Mohamadkhosravi/SINA_Cooling_Control/Hardware/Docs/Read me.docx

تغییرات ورژن I_1.3.5 بر اساس ورژن I_1.3

1- اضافه شدن fiducial point به لایه top past

تغییرات ورژن I_1.3 بر اساس ورژن I_1.2

1- تغییر سوکت پروگرامر
2- تغییر مقدار مقاومت بک لایت از 22 اهم به 10 اهم (R1)

تغییرات ورژن I_1.2 بر اساس ورژن I_1.1

1- دور کردن قطعات از ای سی درایور و انکودر
2- تغییر سوکت پروگرمر

تغییرات ورژن I_1.1 بر اساس ورژن I_1.0

1- Top and bottom paste fix

تغییرات ورژن I_1.0 بر اساس ورژن I_0.9

1- اضافه کردن دیود حفاظت برای نمونه گیری ازvcc4 برای بک لایت

تغییرات ورژن I_0.9 بر اساس ورژن I_0.8

1- اضافه شدن تست پوینت
2- تغییر تمامی فوت پرینت ها (کوچک کردن فوت پرینت ها)

تغییرات ورژن I_0.8 بر اساس ورژن I_0.7

1- اضافه کردن پلیگان زیر پد های خازن الکترولیتی و سویچ
2- بزرگ کردن پد های میکرو کنترلر ( سه برابر محل نشیمنگاه ای سی)
3- کوچک کردن ترمال پد ای سی تغذیه
4- تغییر مدار کنترل ال ای دی بک لایت ال سی دی
5- اضافه کردن مدار حفاظت برای ac

تغییرات ورژن I_0.7 بر اساس ورژن I_0.6

1- جایگزینی آی سی تغذیه ncv4269 با ncv4276

تغییرات ورژن I_0.6 بر اساس ورژن I_0.4

1- تغییر سوراخ 5.4 میلیمتری برد برای جلوگیری کردن از فرورفتن برد هنگام پیچ بستن.
2- تغییر مکان R52 به علت درخواست مهندسی و گیر کردن به بدنه

تغییرات نسخه 1.13.000 بر اساس ورژن 1.09.000 :

1- اصلاح تغییر IC ATMEL و ONSEMI
2- اضافه کرد زمان ریست پانل برای ولتاژ کم یا اضافه تر از حد مجاز

تغییرات نسخه 1.09.000 بر اساس ورژن 1.08.000 :

3- اصلاح ویز ویز کردن اکچویتورها و حذف Back emf
4- اصلاح عملکرد کلید مود در حالت پانل خاموش که دوباره از حالت قبل ادامه نمی داد
