Mohamadkhosravi/SINA_Cooling_Control/Hardware/OutputJobs/Saina-V1.32-1403_05_08.xlsx

BOM Version : Saina V1.32 1403/05/08
PCB Version : Saina V1.3 1403/04/23
Number | Specification |  | smd code | Package | Quantity
SMD components
1 | Thick Film Resistors 2.2Kohms 5% 1/8watt -55°C ~ 155°C | 11000048 | 222 | 0805 | 6 | R5, R6, R23, R24, R36, R37
2 | Thick Film Resistors 1/8watt 5.1Kohms 5% -55°C ~ 155°C | 11000165 | 512 | 0805 | 5 | R10, R27, R28, R34, R35
3 | Thick Film Resistors 1/8watt 10Kohms 5% -55°C ~ 155°C | 11000049 | 103 | 0805 | 12 | R13, R14, R15, R16, R25, R26, R38, R39, R51, R52,R8,R9
4 | Thick Film Resistors 1/8watt 47Kohms 5% -55°C ~ 155°C | 11000166 | 473 | 0805 | 2 | R21, R22
5 | Thick Film Resistors 1/8watt 510Kohms 5% -55°C ~ 155°C | 11000167 | 5103 | 0805 | 2 | R3, R4
6 | Thick Film Resistors 1/4watt 27ohms 1% -55°C ~ 155°C | 11000198 | 27R0 | 1206 | 1 | R50
7 | Thick Film Resistors 1/4watt 1.2Kohms 5% -55°C ~ 155°C | 11000169 | 122 | 1206 | 8 | R40, R41, R42, R43, R44, R45, R46, R53
8 | Thick Film Resistors 1/4watt 2Kohms 5% -55°C ~ 155°C | 11000171 | 202 | 1206 | 1 | R29
9 | Thick Film Resistors 1/4watt 3.6Kohms 1% -55°C ~ 155°C | 11000173 | 3601 | 1206 | 2 | R19, R20
10 | Thick Film Resistors 1/4watt 1.5Kohms 5% -55°C ~ 155°C | 11000170 | 152 | 1206 | 4 | R30, R31, R32, R33
11 | Thick Film Resistors 1/4watt 10Kohms 1% -55°C ~ 155°C | 11000540 | 1002 | 1206 | 2 | R17, R18
12 | Thick Film Resistors 1/8watt 10ohms 5% -55°C ~ 155°C | 11000800 | 100 | 0805 | 1 | R1
13 | Thick Film Resistors 1/8watt 100Kohms 5% -55°C ~ 155°C | 11000829 | 104 | 0805 | 1 | R2
14 | Thick Film Resistors 1/8watt 200Kohms 5% -55°C ~ 155°C | 11000830 | 204 | 0805 | 1 | R7
15 | Thick Film Resistors 1/8watt 470Kohms 5% -55°C ~ 155°C | 11000831 | 474 | 0805 | 1 | R55
16 | Thick Film Resistors 1/8watt 150Kohms 5% -55°C ~ 155°C | 11000832 | 154 | 0805 | 1 | R56
17 | Multilayer Ceramic Capacitors MLCC - SMD/SMT 50V 100nF X7R 10% -55°C ~ 125°C | 11000176 |  | 603 | 2 | C10, C61
18 | Multilayer Ceramic Capacitors MLCC - SMD/SMT 50V 1nF X7R 10% -55°C ~ 125°C | 11000174 |  | 0805 | 1 | C40
19 | Multilayer Ceramic Capacitors MLCC - SMD/SMT 50V 0.01uF X7R 10% -55°C ~ 125°C | 11000175 |  | 0805 | 14 | C17, C18, C19, C20, C21, C22, C24, C25, C26, C27, C28, C36, C39, C41
20 | Multilayer Ceramic Capacitors MLCC - SMD/SMT 50V 0.1uF X7R 10% -55°C ~ 125°C | 11000120 |  | 0805 | 15 | C3, C4, C7, C8, C11, C12, C13, C14, C16, C29, C30, C31, C32, C33, C34
21 | CAP CER 0.01uF 50V X7R 1210 | 11000177 |  | 1210 | 3 | C1, C37, C38
22 | CAP Tantalum 10.0UF 10.0V ESR<5Ohm 2000 Hrs @ 85°C -55°C ~ 125°C AEC-Q200 | 11000196 |  | 1206 (3216 Metric) | 1 | C5
23 | Aluminum Electrolytic Capacitors - SMD 25V 10uF 20% 2000 Hrs @ 85°C -55°C ~ 105°C Φ4*5/4mm | 11000179 |  | SMD-2 | 2 | C9, C15
24 | Aluminum Electrolytic Capacitors - SMD 50V 10uF 20% 2000 Hrs @ 85°C -55°C ~ 105°C Φ5*5/4mm | 11000195 |  | SMD-2 | 1 | C35
25 | Aluminum Electrolytic Capacitors - SMD 50V 100uF 2000 Hrs @ 85°C 20% -55°C ~ 105°C Φ8*10/5mm | 11000178 |  | SMD-2 | 2 | C2, C6
26 | 47UH 6*6*4mm | 11000180 |  | 6040 | 1 | LX1
27 | 1N4148WQ-7-F | 11000181 | W1 | SOD-123 | 9 | D5, D6, D13, D14, D15,D9, D10, D11, D12
28 | RS1M DIODE GEN PURP 1KV 1A -55°C ~ 150°C | 11000183 | RS1M | DO-214AC | 5 | D2, D3, D4, D7, D8
29 | S3M DIODE GEN PURP 1KV 3A -55°C ~ 150°C | 11000184 | S3M | DO-214AB | 1 | D1
30 | BC817-40 Bipolar Transistors - BJT 500mA 50V NPN -55°C ~ 150°C | 11000185 | 6CW | SOT-23 | 3 | Q1, Q3, Q4
31 | BCP56-16T1G TRANS NPN 80V 1A -65°C ~ 150°C | 11000186 |  | SOT-223 | 2 | Q5, Q6
32 | NCV8402ASTT1G IC DVR LO SIDE 42V 2.0A -40°C ~ 150°C | 11000187 |  | SOT-223 | 1 | Q2
33 | NCV4276DS50R4G IC REG LINEAR 5V 400MA -40°C ~ 125°C | 11000549 |  | D2PAK 5−LEAD | 1 | U1
34 | LM2904DT IC OPAMP GP 700KHZ -40°C ~ 125°C | 11000189 |  | SOP-8 | 1 | U5
35 | CAT93C46VI-JT3 | 11000164 |  | SOIC -8 | 1 | U8
36 | HT16K23 RAM Mapping 20*4/16*8 LCD Controller Driver -40°C ~ 85°C (reel packing) | 11000190 |  | SOP-28 | 1 | U3
37 | ATA6836C-TIQW IC HALF-BRIDGE DRVR SPI -40°C ~ 150°C (reel packing) | 11000210 |  | SOP-28 | 1 | U4
Alternative | NCV7708BDWR2G 28-SOIC | 11000193 |  | SOP-28 | 1 | U4
38 | XMC1302T038X0032ABXUMA1 PG-TSSOP-38-9 | 11000215 |  | PG-TSSOP-38-9 | 1 | U2
39 | TZ-SMD0805Y2HD LED805 YELLOW 0805 | 11000334 |  |  | 1 | L9
40 | SKPMAPE010 SWITCH 6*6*5MM , Alps | 11000192 |  |  | 1 | S4
Alternative | LED L-C170KYCT-SK | 11000718 |  |  | 1 | L9
41 | TZ-SMD1206W3HL LED WHITE 1206 | 11000338 |  |  | 6 | L12-L14-L16-L15-L13-L17
Alternative | LED L-C150WZDT-HT | 11000719 |  |  | 6 | L12-L14-L16-L15-L13-L17
42 | TZ-SMD1206B2HD LED BLUE 1206 | 11000336 |  |  | 1 | L11
Alternative | LED L-C150LBCT | 11000720 |  |  | 1 | L11
43 | TZ-SMD1206R2HD LED RED 1206 | 11000337 |  |  | 1 | L10
Alternative | LED L-C150KRCT | 11000721 |  |  | 1 | L10
44 | LED L-T670WDT | 11000335 |  |  | 8 | L1-L2-L3-L4-L5-L6-L7-L8
Alternative | H3528AW34E03012 LED white | 11000615 |  |  | 8 | L1-L2-L3-L4-L5-L6-L7-L8
Through-hole components
45 | EC28A1560401 Rotary Encoder, Straight, Without Push Switch | 11000197 |  |  | 1 | SE1
46 | connector 8p | 12100135 |  |  | 1 | J2
47 | connector 18Pin | 12100483 |  |  | 1 | J3
48 | LCD Saina | 11000471 |  |  | 1 | LCD1
