Mohamadkhosravi/SINA_Cooling_Control/Hardware/3DModels/SOLID/Connector1.sldprt

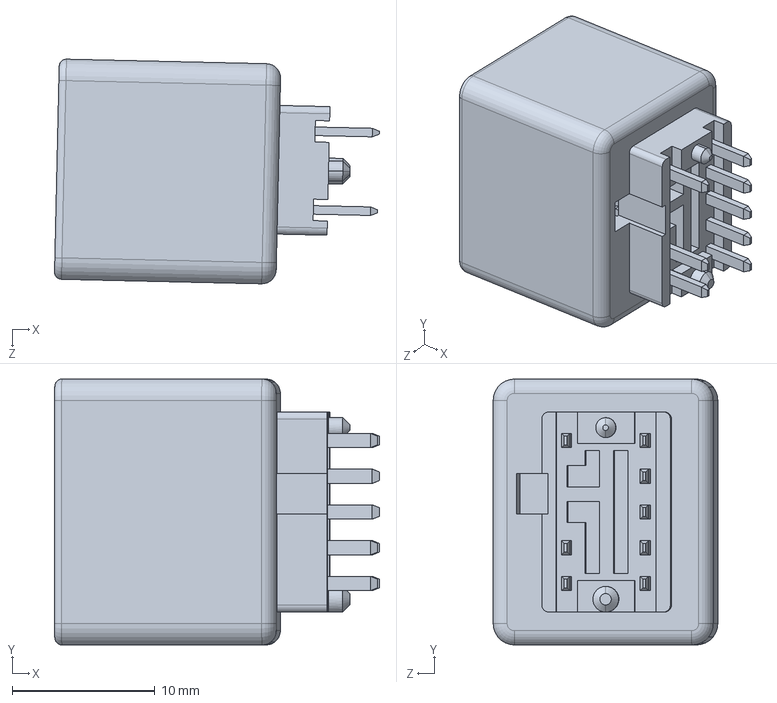
[picture p1: CAD file, 2025-05-04]
Hardware/3DModels/SOLID/Connector1.sldprt
22.7 x 18.6 x 15.7 mm
