Mohamadkhosravi/SINA_Cooling_Control/Hardware/3DModels/SOLID/lcd holder.sldprt

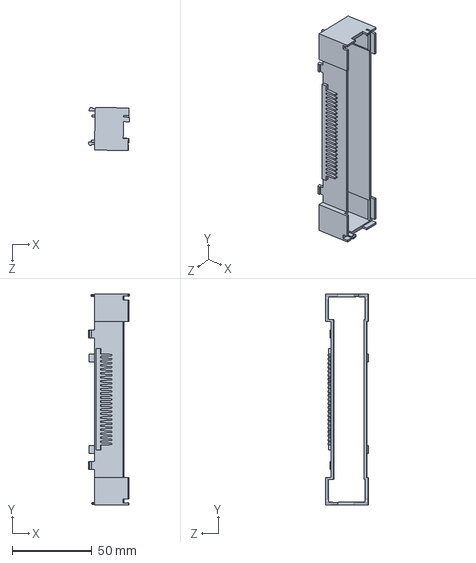
[picture p2: CAD file, 2025-05-04]
Hardware/3DModels/SOLID/lcd holder.sldprt
25.9 x 132.7 x 27.3 mm
