Mohamadkhosravi/SINA_Cooling_Control/Hardware/3DModels/STEP/connector2.STEP

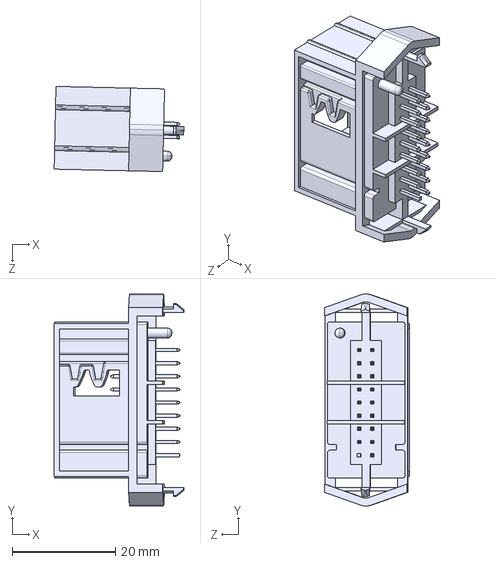
[picture p3: CAD file, 2025-05-04]
Hardware/3DModels/STEP/connector2.STEP
25.1 x 41.0 x 16.5 mm
