Mohamadkhosravi/SINA_Cooling_Control/Hardware/3DModels/STEP/back panel.STEP

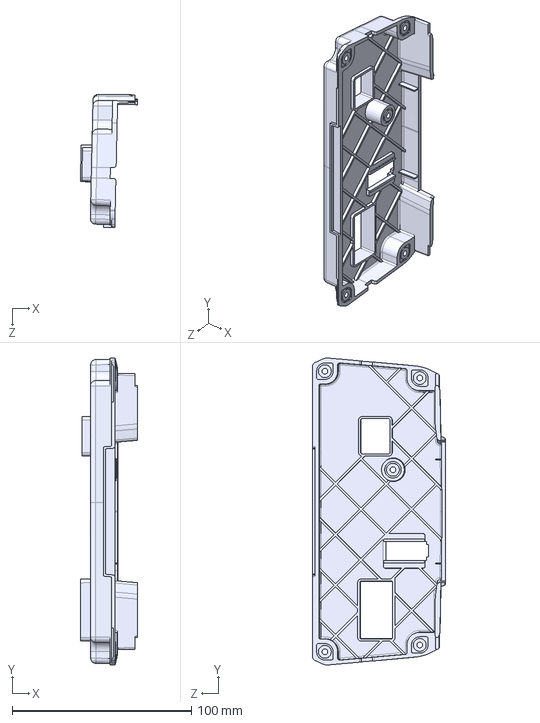
[picture p4: CAD file, 2025-05-04]
Hardware/3DModels/STEP/back panel.STEP
32.0 x 171.4 x 74.4 mm
