Mohamadkhosravi/SINA_Cooling_Control/Hardware/3DModels/SOLID/ASSEM CCU SAYNA-ASSEM CCU SAYNA.STEP

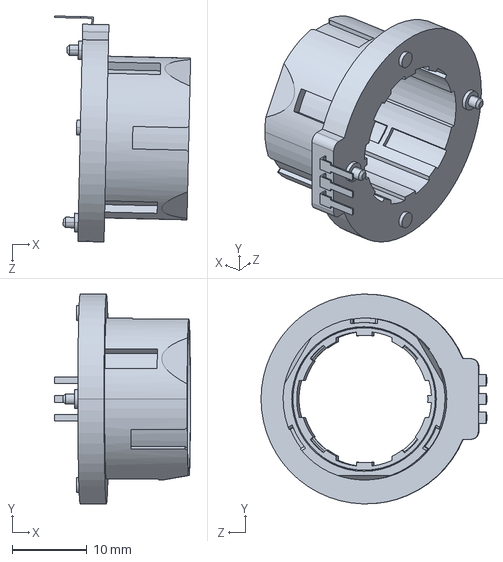
[picture p5: CAD file, 2025-05-04]
Hardware/3DModels/SOLID/ASSEM CCU SAYNA-ASSEM CCU SAYNA.STEP
18.2 x 28.0 x 30.2 mm
