Mohamadkhosravi/SINA_Cooling_Control/(list of files, cad)

Other CAD files:
Hardware/3DModels/DWG/front.DWG
Hardware/3DModels/STEP/Connector1.STEP
Hardware/3DModels/SOLID/connector2.SLDPRT
Hardware/3DModels/SOLID/back panel.sldprt
Hardware/3DModels/STEP/lcd holder.STEP
Hardware/3DModels/SOLID/ASSEM CCU SAYNA-ASSEM CCU SAYNA.STEP.SLDPRT
Hardware/3DModels/DWG/back panel.DWG
Hardware/3DModels/DWG/lcd holder.DWG
