Mohamadkhosravi/SINA_Cooling_Control/Hardware/Docs/control panel DRAWING.pdf

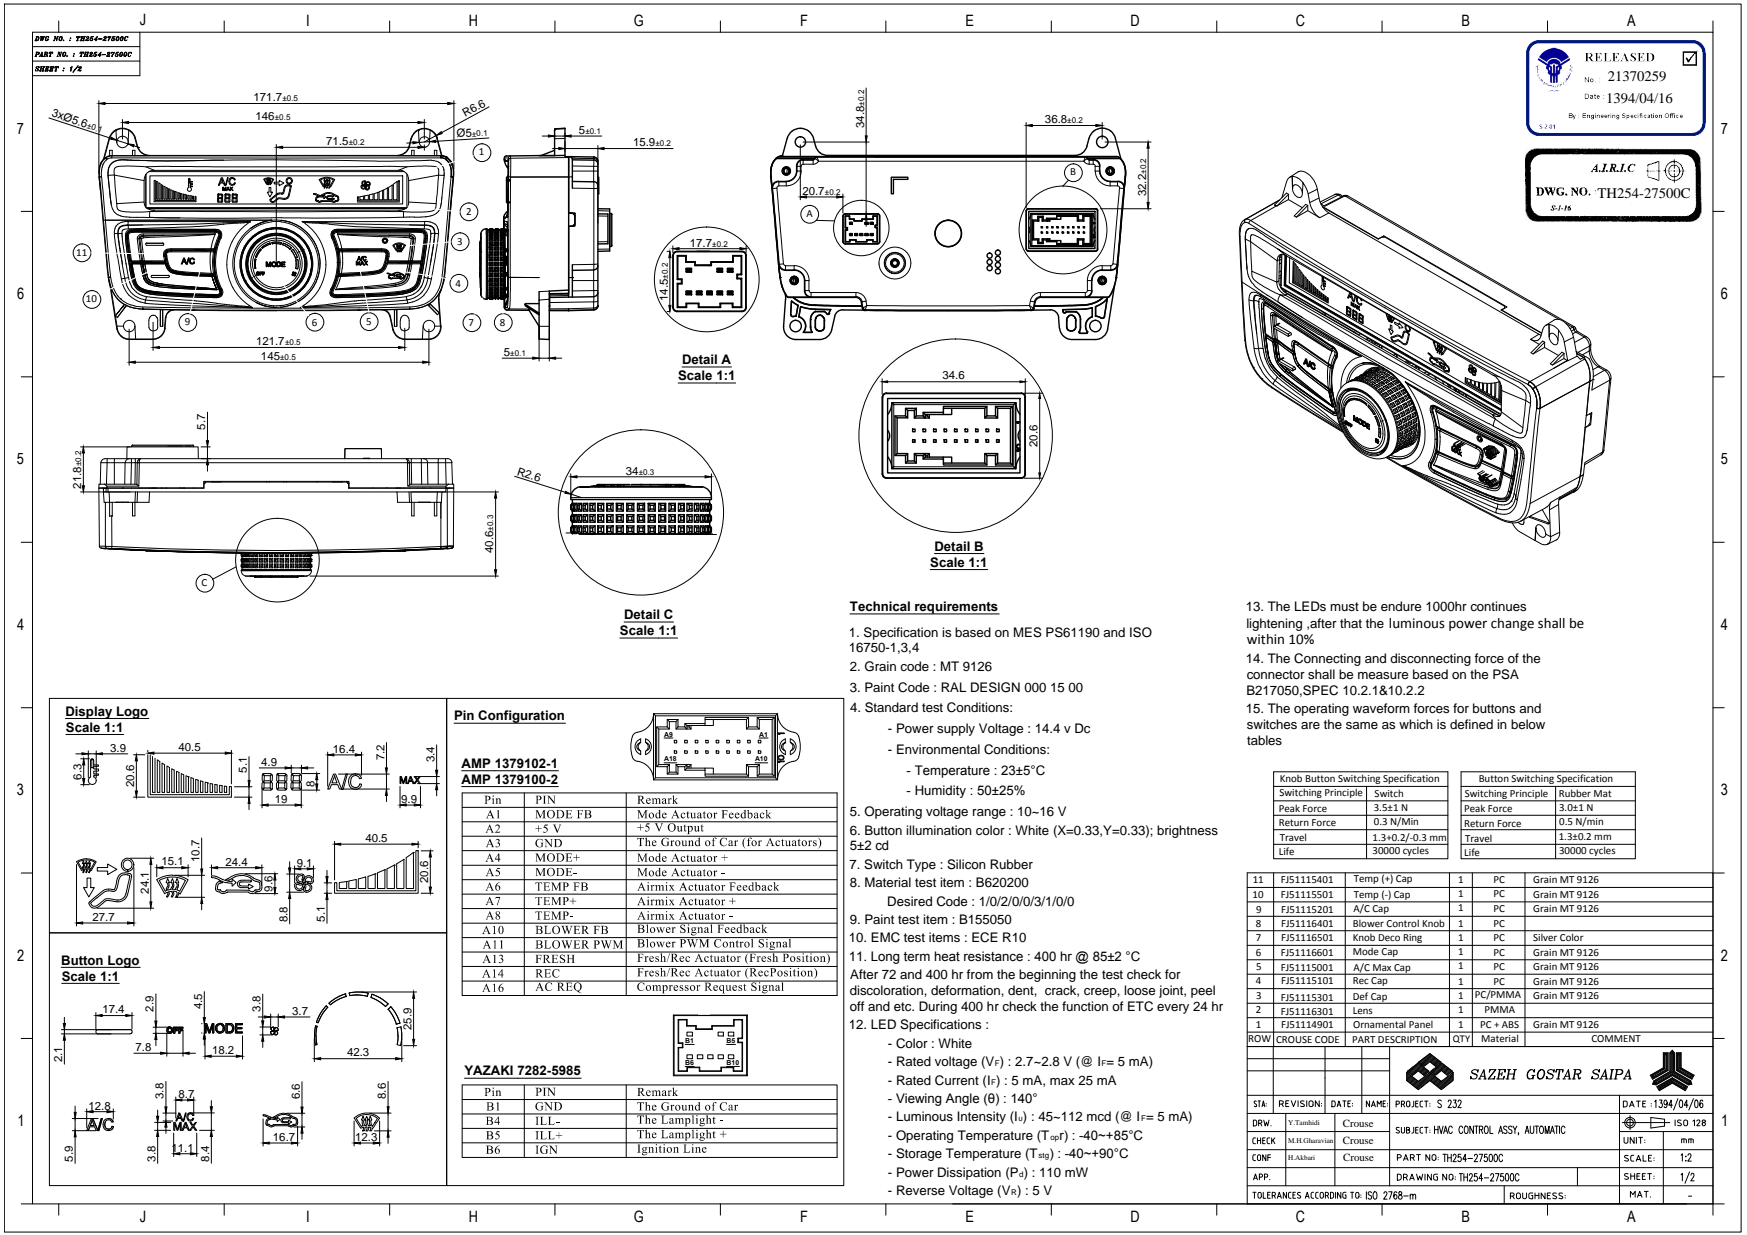
[picture p6: page 1]
Technical requirements; Desired Code : 1/0/2/0/0/3/1/0/0; Display Logo Scale 1:1; Button Logo Scale 1:1; Pin Configuration; AMP 1379102-1 AMP 1379100-2; CROUSE CODE PART DESCRIPTION; QTY Material; COMMENT; Ornamental Panel; Def Cap; Rec Cap; A/C Max Cap; Mode Cap; Knob Deco Ring; Blower Control Knob; A/C Cap; Temp (-) Cap; Temp (+) Cap; PC + ABS; Detail A Scale 1:1; Detail B Scale 1:1; Rubber Mat; 0.5 N/min; 30000 cycles; 0.3 N/Min 1.3+0.2/-0.3 mm 30000 cycles; Grain MT 9126; Silver Color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

13. The LEDs must be endure 1000hr continues
lightening ,after that the luminous power change shall be
within 10%
14. The Connecting and disconnecting force of the
connector shall be measure based on the PSA
B217050,SPEC 10.2.1&10.2.2
15. The operating waveform forces for buttons and
switches are the same as which is defined in below
tables

1. Specification is based on MES PS61190 and ISO
2. Grain code : MT 9126
3. Paint Code : RAL DESIGN 000 15 00
4. Standard test Conditions:

- Power supply Voltage : 14.4 v Dc
- Environmental Conditions:
7HPSHUDWXUH±°&
+XPLGLW\±

Knob Button Switching Specification
Switching Principle
Peak Force
Return Force
Travel
Life

Button Switching Specification

5. Operating voltage range : 10~16 V
6. Button illumination color : White (X=0.33,Y=0.33); brightness
7. Switch Type : Silicon Rubber
8. Material test item : B620200

9. Paint test item : B155050
10. EMC test items : ECE R10
/RQJWHUPKHDWUHVLVWDQFHKU#±°&
After 72 and 400 hr from the beginning the test check for
discoloration, deformation, dent, crack, creep, loose joint, peel
off and etc. During 400 hr check the function of ETC every 24 hr
12. LED Specifications :

- Color : White
- Rated voltage (VF) : 2.7~2.8 V (@ IF= 5 mA)
- Rated Current (IF) : 5 mA, max 25 mA
9LHZLQJ$QJOH°
- Luminous Intensity (I) : 45~112 mcd (@ IF= 5 mA)
- Operating Temperature (TopUa°&
- Storage Temperature (Tstga°&
- Power Dissipation (Pd) : 110 mW
- Reverse Voltage (VR) : 5 V

Y.Tamhidi | Crouse
Crouse Crouse M.H.Gharavian H.Akbari

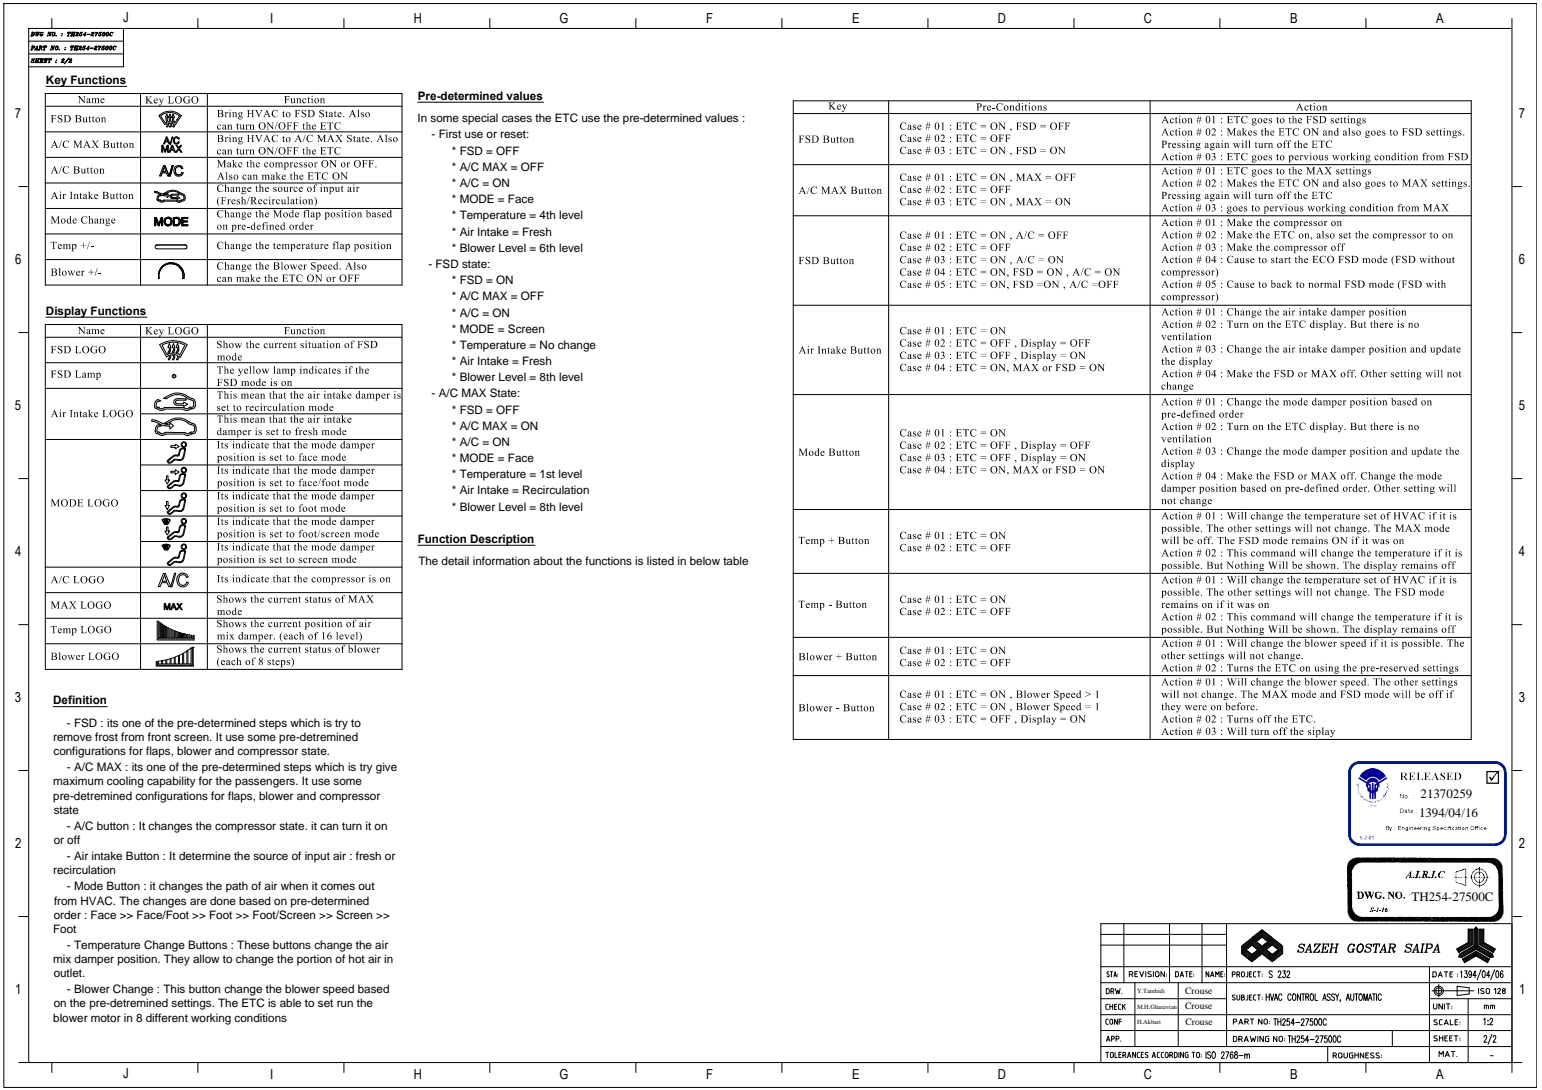
[picture p7: page 2]
Function Description; Key Functions; Display Functions

Pre-determined values

In some special cases the ETC use the pre-determined values :
- First use or reset:
* FSD = OFF
* A/C MAX = OFF
* MODE = Face
* Temperature = 4th level
* Air Intake = Fresh
* Blower Level = 6th level
- FSD state:
* FSD = ON
* MODE = Screen
* Temperature = No change
* Blower Level = 8th level
- A/C MAX State:
* A/C MAX = ON
* Temperature = 1st level
* Air Intake = Recirculation

The detail information about the functions is listed in below table

- FSD : its one of the pre-determined steps which is try to
remove frost from front screen. It use some pre-detremined
configurations for flaps, blower and compressor state.
- A/C MAX : its one of the pre-determined steps which is try give
maximum cooling capability for the passengers. It use some
pre-detremined configurations for flaps, blower and compressor
state
- A/C button : It changes the compressor state. it can turn it on
or off

- Air intake Button : It determine the source of input air : fresh or
recirculation
- Mode Button : it changes the path of air when it comes out
from HVAC. The changes are done based on pre-determined
order : Face >> Face/Foot >> Foot >> Foot/Screen >> Screen >>
Foot
- Temperature Change Buttons : These buttons change the air
mix damper position. They allow to change the portion of hot air in
outlet.

- Blower Change : This button change the blower speed based
on the pre-detremined settings. The ETC is able to set run the
blower motor in 8 different working conditions

Y.Tamhidi | Crouse
Crouse Crouse M.H.Gharavian H.Akbari
