Mohamadkhosravi/SINA_Cooling_Control/(list of files, drawings)

Other design files:
Hardware/PCB/Panel.PcbDoc
Hardware/Saina.PrjPcb
