Mohamadkhosravi/SINA_Cooling_Control/(commit log)

2025-05-04 Start Development
    [ASSEM CCU SAYNA-ASSEM CCU SAYNA.STEP, ASSEM CCU SAYNA-ASSEM CCU SAYNA.STEP.SLDPRT, Connector1.STEP, Connector1.sldprt, Panel.PcbDoc, Saina-V1.3-1403_04_23.xlsx, Saina-V1.32-1403_05_08.xlsx, Saina-V1.33-1403_05_14.xlsx]
2025-05-05 + New MCU to SCH
    [Saina.Sch]
2025-05-05 SCH ,Done
    [Panel.PcbDoc, Saina.PrjPcb, Saina.Sch]
2025-05-06 Placement is Done
    [Copy of Saina.pcb, Saina.PrjPcb, Saina.Sch]
2025-05-07 PCB Routing is Done,The DRC error between the microcontroller and the power supply still exists.
    [Saina.PrjPcb, Saina.Sch]
2025-05-10 SCH and PCB are ,Done
    [Copy of Saina.pcb, Panel.PcbDoc, Saina.PrjPcb, Saina.Sch]
2025-05-10 PCB:04-02-20: SCH File -> SCHDOC File
    [Panel.PcbDoc, Saina.PrjPcb, Saina.Sch]
